poisk-1/hdd_card/kicad/hdd_card.kicad_pcb

## KiCad design kicad/hdd_card.kicad_pcb (2023-01-22)

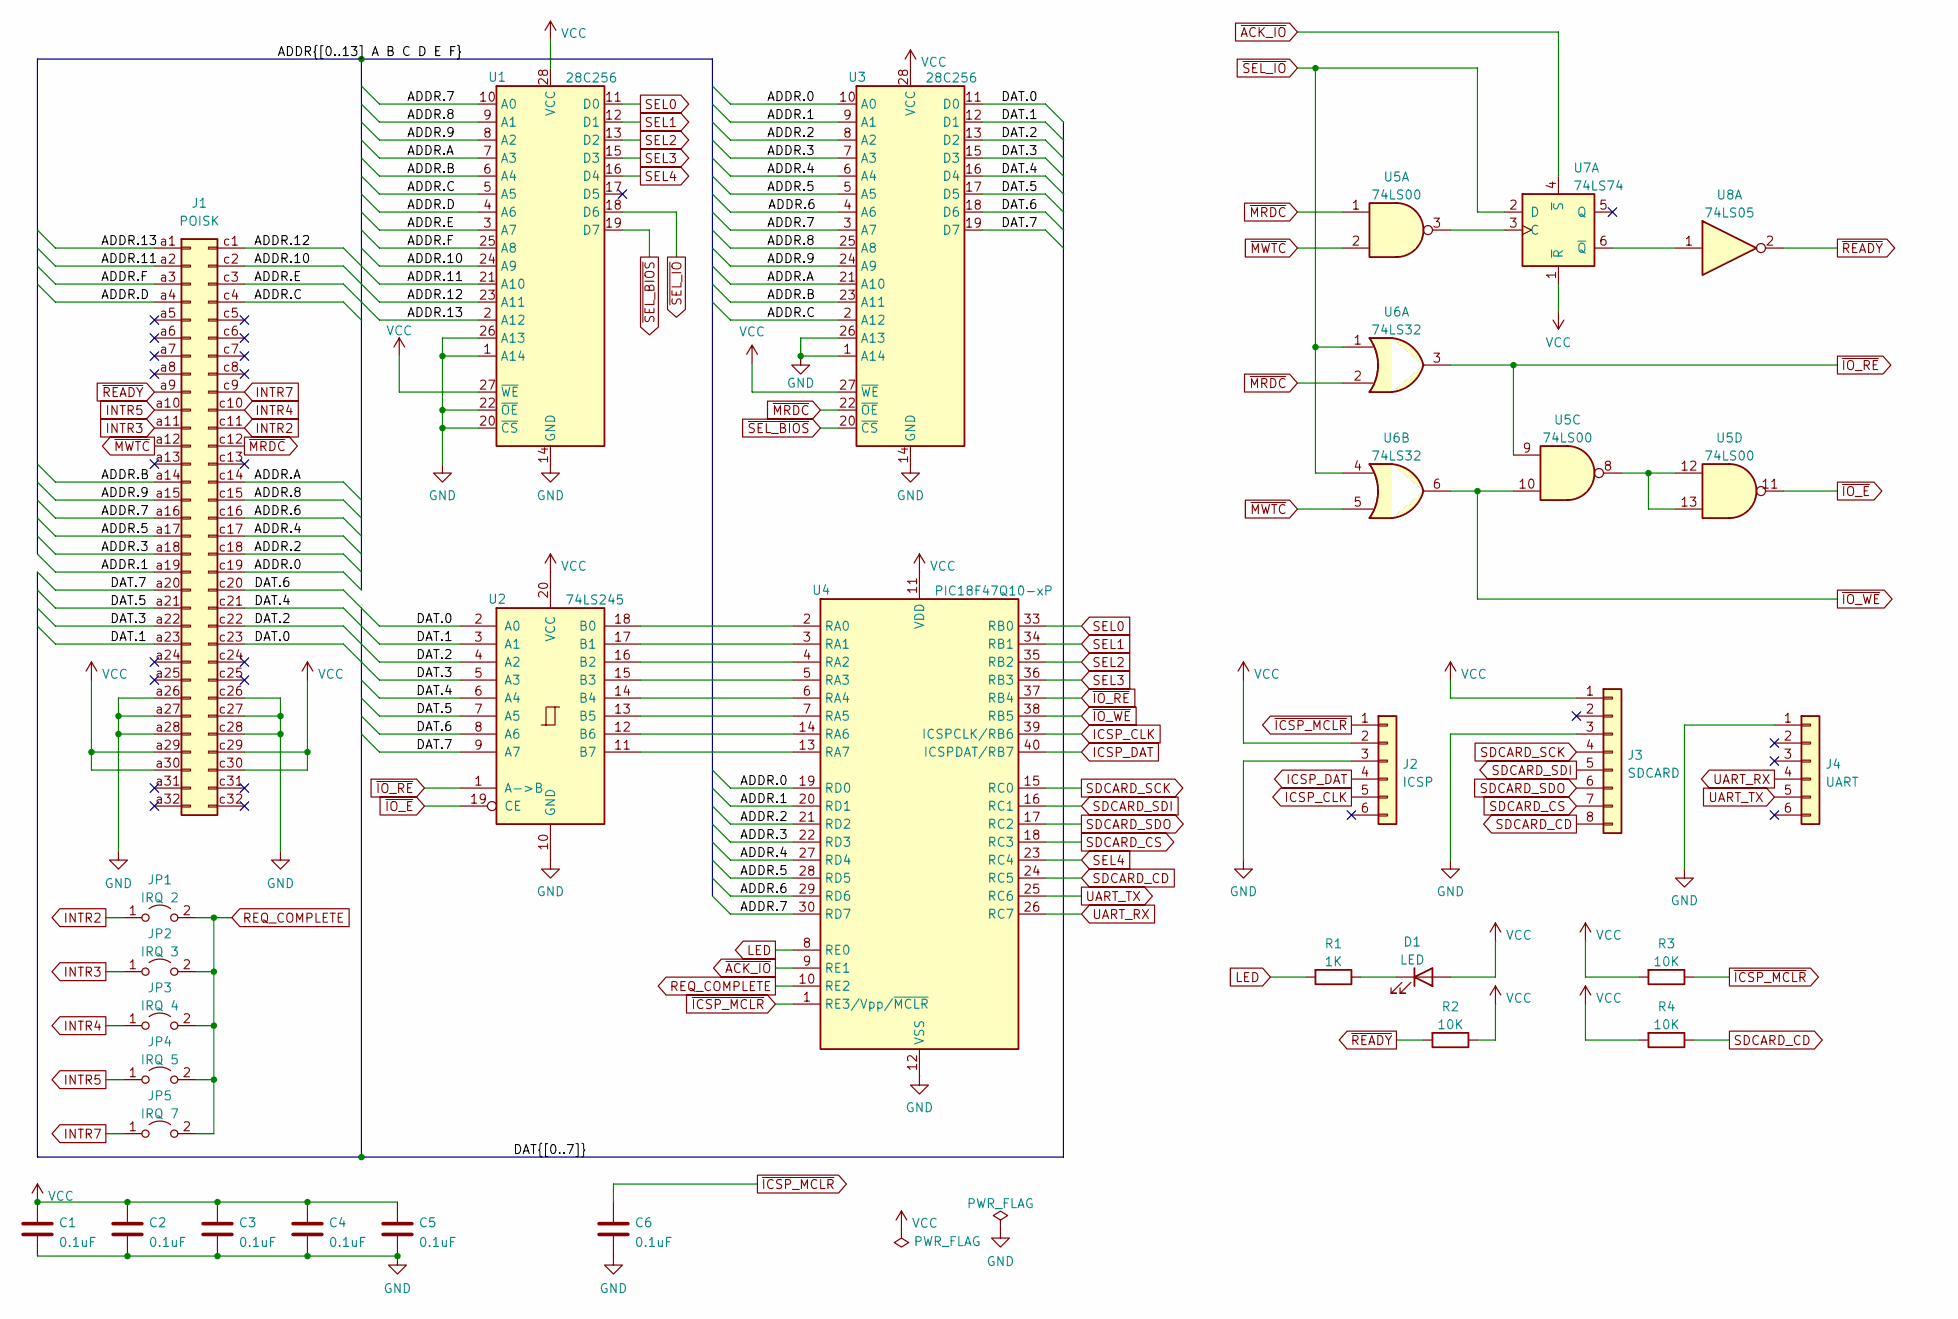
[picture p1: schematic hdd_card.kicad_sch]

Parts:
C1, C2, C3, C4, C5, C6: 0.1uF; C_Disc_D3.0mm_W1.6mm_P2.50mm
D1: LED; LED_D5.0mm
J1: POISK; DIN41612_R_2x32_Male_Horizontal_THT
J2: ICSP; PinHeader_1x06_P2.54mm_Vertical
J3: SDCARD; PinHeader_1x08_P2.54mm_Vertical
J4: UART; PinHeader_1x06_P2.54mm_Vertical
JP1: IRQ 2; PinHeader_1x02_P2.54mm_Vertical
JP2: IRQ 3; PinHeader_1x02_P2.54mm_Vertical
JP3: IRQ 4; PinHeader_1x02_P2.54mm_Vertical
JP4: IRQ 5; PinHeader_1x02_P2.54mm_Vertical
JP5: IRQ 7; PinHeader_1x02_P2.54mm_Vertical
R1: 1K; R_Axial_DIN0207_L6.3mm_D2.5mm_P7.62mm_Horizontal
R2, R3, R4: 10K; R_Axial_DIN0207_L6.3mm_D2.5mm_P7.62mm_Horizontal
U1, U3: 28C256; DIP-28_W15.24mm
U2: 74LS245; DIP-20_W7.62mm
U4: PIC18F47Q10-xP; DIP-40_W15.24mm
U5: 74LS00; DIP-14_W7.62mm
U6: 74LS32; DIP-14_W7.62mm
U7: 74LS74; DIP-14_W7.62mm
U8: 74LS05; DIP-14_W7.62mm

Connections:
/ADDR.0: J1.c19, U3.10 (A0), U4.19 (RD0)
/ADDR.1: J1.a19, U3.9 (A1), U4.20 (RD1)
/ADDR.2: J1.c18, U3.8 (A2), U4.21 (RD2)
/ADDR.3: J1.a18, U3.7 (A3), U4.22 (RD3)
/ADDR.4: J1.c17, U3.6 (A4), U4.27 (RD4)
/ADDR.5: J1.a17, U3.5 (A5), U4.28 (RD5)
/ADDR.6: J1.c16, U3.4 (A6), U4.29 (RD6)
/ADDR.7: J1.a16, U1.10 (A0), U3.3 (A7), U4.30 (RD7)
/ADDR.8: J1.c15, U1.9 (A1), U3.25 (A8)
/ADDR.9: J1.a15, U1.8 (A2), U3.24 (A9)
/ADDR.10: J1.c2, U1.24 (A9)
/ADDR.11: J1.a2, U1.21 (A10)
/ADDR.12: J1.c1, U1.23 (A11)
/ADDR.13: J1.a1, U1.2 (A12)
/ADDR.A: J1.c14, U1.7 (A3), U3.21 (A10)
/ADDR.B: J1.a14, U1.6 (A4), U3.23 (A11)
/ADDR.C: J1.c4, U1.5 (A5), U3.2 (A12)
/ADDR.D: J1.a4, U1.4 (A6)
/ADDR.E: J1.c3, U1.3 (A7)
/ADDR.F: J1.a3, U1.25 (A8)
/DAT.0: J1.c23, U2.2 (A0), U3.11 (D0)
/DAT.1: J1.a23, U2.3 (A1), U3.12 (D1)
/DAT.2: J1.c22, U2.4 (A2), U3.13 (D2)
/DAT.3: J1.a22, U2.5 (A3), U3.15 (D3)
/DAT.4: J1.c21, U2.6 (A4), U3.16 (D4)
/DAT.5: J1.a21, U2.7 (A5), U3.17 (D5)
/DAT.6: J1.c20, U2.8 (A6), U3.18 (D6)
/DAT.7: J1.a20, U2.9 (A7), U3.19 (D7)
GND: C1.2, C2.2, C3.2, C4.2, C5.2, C6.2, J1.a26, J1.a27, J1.a28, J1.c26, J1.c27, J1.c28, J2.3, J3.3, J4.1, U1.1 (A14), U1.14 (GND), U1.20 (~CS), U1.22 (~OE), U1.26 (A13), U2.10 (GND), U3.1 (A14), U3.14 (GND), U3.26 (A13), U4.12 (VSS), U4.31 (VSS)
ICSP_CLK: J2.5, U4.39 (ICSPCLK/RB6)
ICSP_DAT: J2.4, U4.40 (ICSPDAT/RB7)
INTR2: J1.c11, JP1.1 (A)
INTR3: J1.a11, JP2.1 (A)
INTR4: J1.c10, JP3.1 (A)
INTR5: J1.a10, JP4.1 (A)
INTR7: J1.c9, JP5.1 (A)
LED: R1.2, U4.8 (RE0)
unnamed: D1.1 (K), R1.1
unnamed: U2.11 (B7), U4.13 (RA7)
unnamed: U2.12 (B6), U4.14 (RA6)
unnamed: U2.13 (B5), U4.7 (RA5)
unnamed: U2.14 (B4), U4.6 (RA4)
unnamed: U2.15 (B3), U4.5 (RA3)
unnamed: U2.16 (B2), U4.4 (RA2)
unnamed: U2.17 (B1), U4.3 (RA1)
unnamed: U2.18 (B0), U4.2 (RA0)
unnamed: U5.3, U7.3 (C)
unnamed: U5.8, U5.12, U5.13
unnamed: U7.6 (~Q), U8.1
REQ_COMPLETE: JP1.2 (B), JP2.2 (B), JP3.2 (B), JP4.2 (B), JP5.2 (B), U4.10 (RE2)
SDCARD_CS: J3.7, U4.18 (RC3)
SDCARD_SCK: J3.4, U4.15 (RC0)
SDCARD_SDI: J3.5, U4.16 (RC1)
SDCARD_SDO: J3.6, U4.17 (RC2)
SEL0: U1.11 (D0), U4.33 (RB0)
SEL1: U1.12 (D1), U4.34 (RB1)
SEL2: U1.13 (D2), U4.35 (RB2)
SEL3: U1.15 (D3), U4.36 (RB3)
UART_RX: J4.4, U4.26 (RC7)
UART_TX: J4.5, U4.25 (RC6)
VCC: C1.1, C2.1, C3.1, C4.1, C5.1, D1.2 (A), J1.a29, J1.a30, J1.c29, J1.c30, J2.2, J3.1, R2.1, R3.2, R4.2, U1.27 (~WE), U1.28 (VCC), U2.20 (VCC), U3.27 (~WE), U3.28 (VCC), U4.11 (VDD), U4.32 (VDD), U7.1 (~R)
~ACK_IO: U4.9 (RE1), U7.4 (~S)
~ICSP_MCLR: C6.1, J2.1, R3.1, U4.1 (RE3/Vpp/~MCLR)
~IO_E: U2.19 (CE), U5.11
~IO_RE: U2.1 (A->B), U4.37 (RB4), U5.9, U6.3
~IO_WE: U4.38 (RB5), U5.10, U6.6
~MRDC: J1.c12, U3.22 (~OE), U5.1, U6.2
~MWTC: J1.a12, U5.2, U6.5
~READY: J1.a9, R2.2, U8.2
~SEL_BIOS: U1.19 (D7), U3.20 (~CS)
~SEL_IO: U1.18 (D6), U6.1, U6.4, U7.2 (D)

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
Board: 2 copper layers, 28 parts (0 on the bottom side), 72 nets, no tracks yet.
