poisk-1/hdd_card/firmware/hdd_card.X/main.c

/**
  Generated Main Source File

  Company:
    Microchip Technology Inc.

  File Name:
    main.c

  Summary:
    This is the main file generated using PIC10 / PIC12 / PIC16 / PIC18 MCUs

  Description:
    This header file provides implementations for driver APIs for all modules selected in the GUI.
    Generation Information :
        Product Revision  :  PIC10 / PIC12 / PIC16 / PIC18 MCUs - 1.81.8
        Device            :  PIC18F47Q83
        Driver Version    :  2.00
 */

/*
    (c) 2018 Microchip Technology Inc. and its subsidiaries. 
    
    Subject to your compliance with these terms, you may use Microchip software and any 
    derivatives exclusively with Microchip products. It is your responsibility to comply with third party 
    license terms applicable to your use of third party software (including open source software) that 
    may accompany Microchip software.
    
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
    IN NO EVENT WILL MICROCHIP BE LIABLE FOR ANY INDIRECT, SPECIAL, PUNITIVE, 
    INCIDENTAL OR CONSEQUENTIAL LOSS, DAMAGE, COST OR EXPENSE OF ANY KIND 
    WHATSOEVER RELATED TO THE SOFTWARE, HOWEVER CAUSED, EVEN IF MICROCHIP 
    HAS BEEN ADVISED OF THE POSSIBILITY OR THE DAMAGES ARE FORESEEABLE. TO 
    THE FULLEST EXTENT ALLOWED BY LAW, MICROCHIP'S TOTAL LIABILITY ON ALL 
    CLAIMS IN ANY WAY RELATED TO THIS SOFTWARE WILL NOT EXCEED THE AMOUNT 
    OF FEES, IF ANY, THAT YOU HAVE PAID DIRECTLY TO MICROCHIP FOR THIS 
    SOFTWARE.
 */

#include <string.h>

#include "mcc_generated_files/mcc.h"

static FATFS fs;

#define CTRL_BUFFER_SIZE 0x200
#define SECTOR_SIZE 0x200
#define BUFFER_SECTORS 15
#define DATA_BUFFER_SIZE (SECTOR_SIZE * BUFFER_SECTORS)
#define IO_BUFFER_SIZE (CTRL_BUFFER_SIZE + DATA_BUFFER_SIZE)

static uint8_t io_buffer[IO_BUFFER_SIZE];

static uint8_t *ctrl_buffer = &io_buffer[0];
static uint8_t *data_buffer = &io_buffer[CTRL_BUFFER_SIZE];

#define ACK_IO_Strobe() {ACK_IO_SetLow();ACK_IO_SetHigh();}

void __interrupt() INTERRUPT_InterruptManager(void) {
    if (PIE1bits.INT0IE == 1 && PIR1bits.INT0IF == 1) {
        EXT_INT0_InterruptFlagClear();        
        TRISA = 0x00;
        PORTA = io_buffer[(((PORTB & 0xf) | (PORTC & 0x10)) << 8) | PORTD];

        ACK_IO_Strobe();

        TRISA = 0xff;
    } else if (PIE6bits.INT1IE == 1 && PIR6bits.INT1IF == 1) {
        EXT_INT1_InterruptFlagClear();
        io_buffer[(((PORTB & 0xf) | (PORTC & 0x10)) << 8) | PORTD] = PORTA;

        ACK_IO_Strobe();
    }
}

enum Request {
    CTRL_REQUEST_DONE = 0,
    CTRL_REQUEST_CHECK = 0x1,
    CTRL_REQUEST_SCAN = 0x2,
    CTRL_REQUEST_RESET = 0x3,
    CTRL_REQUEST_READ = 0x4,
    CTRL_REQUEST_READ_NEXT = 0x5,
    CTRL_REQUEST_WRITE = 0x6,
    CTRL_REQUEST_WRITE_NEXT = 0x7,
    CTRL_REQUEST_VERIFY = 0x8,
    CTRL_REQUEST_READ_PARAMS_FUN8H = 0x9,
    CTRL_REQUEST_READ_PARAMS_FUN15H = 0xa,
    CTRL_REQUEST_DETECT_MEDIA_CHANGE = 0xb,
};

enum Status {
    CTRL_STATUS_READY = 0,
    CTRL_STATUS_BUSY = 0xff
};

enum DriveReqStatus {
    STATUS_NO_ERROR = 0,
    STATUS_BAD_SECTOR = 0x2,
    STATUS_WRITE_PROTECTED = 0x3,
    STATUS_DISK_CHANGED = 0x6,
    STATUS_CONTROLLER_FAILED = 0x20
};

void invert_buffer(uint8_t *buffer, size_t size) {
    for (size_t i = 0; i < size; i++) {
        buffer[i] = ~buffer[i];
    }
}

struct RWVReq {
    uint8_t low_cylinder_number;
    uint8_t sector_and_high_cylinder_numbers;
    uint8_t head_number;
    uint8_t drive_number;

    uint8_t sectors_count;

    uint8_t status;
    uint8_t sectors_last_r_next_w_count;
};

struct ScanReq {
    uint8_t number_of_floppy_drives;
    uint8_t number_of_hard_drives;
};

struct ReadParamsFun8hReq {
    uint8_t drive_number;

    uint8_t success;

    uint8_t drive_type;
    uint8_t max_low_cylinder_number;
    uint8_t max_sector_and_high_cylinder_numbers;
    uint8_t max_head_number;
    uint8_t number_of_drives;
};

struct ReadParamsFun15hReq {
    uint8_t drive_number;

    uint8_t success;

    uint8_t drive_type;
};

struct DetectMediaChangeReq {
    uint8_t drive_number;

    uint8_t status;
};

union Req {
    struct RWVReq rwv_req;
    struct ScanReq scan_req;
    struct ReadParamsFun8hReq read_params_fun8h_req;
    struct ReadParamsFun15hReq read_params_fun15h_req;
    struct DetectMediaChangeReq detect_media_change;
};

struct Ctrl {
    uint8_t status;
    uint8_t request;
    union Req req;
};

enum DriveTypeFun8h {
    FUN8H_DRIVE_TYPE_FLOPPY_360 = 1,
    FUN8H_DRIVE_TYPE_FLOPPY_1200 = 2,
    FUN8H_DRIVE_TYPE_FLOPPY_720 = 3,
    FUN8H_DRIVE_TYPE_FLOPPY_1440 = 4
};

enum DriveTypeFun15h {
    FUN15H_DRIVE_TYPE_FLOPPY_DISK = 2,
    FUN15H_DRIVE_TYPE_HARD_DISK = 3
};

struct Drive {
    FIL image_file;

    bool read_only;
    bool media_changed;

    uint8_t drive_type_fun8h;
    uint8_t drive_type_fun15h;

    size_t number_of_heads;
    size_t number_of_sectors;
    size_t number_of_cylinders;
};

#define MAX_NUMBER_FLOPPY_DRIVES 4
#define MAX_NUMBER_HARD_DRIVES 2

const char* floppy_image_file_names[MAX_NUMBER_FLOPPY_DRIVES] = {"FLOPPY0.IMG", "FLOPPY1.IMG", "FLOPPY2.IMG", "FLOPPY3.IMG"};
const char* floppy_info_file_names[MAX_NUMBER_FLOPPY_DRIVES] = {"FLOPPY0.TXT", "FLOPPY1.TXT", "FLOPPY2.TXT", "FLOPPY3.TXT"};
const char* floppy_ro_file_names[MAX_NUMBER_FLOPPY_DRIVES] = {"FLOPPY0.RO", "FLOPPY1.RO", "FLOPPY2.RO", "FLOPPY3.RO"};
const char* hard_image_file_names[MAX_NUMBER_HARD_DRIVES] = {"HARD0.IMG", "HARD1.IMG"};

struct Drive floppy_drives[MAX_NUMBER_FLOPPY_DRIVES];
struct Drive hard_drives[MAX_NUMBER_HARD_DRIVES];

#define FLOPPY_IMAGE_FILE_CLTBL_SIZE 16
#define HARD_IMAGE_FILE_CLTBL_SIZE 64

DWORD floppy_image_file_cltbl[MAX_NUMBER_FLOPPY_DRIVES][FLOPPY_IMAGE_FILE_CLTBL_SIZE];
DWORD hard_image_file_cltbl[MAX_NUMBER_HARD_DRIVES][HARD_IMAGE_FILE_CLTBL_SIZE];

#define FLOPPY_SECTOR_SIZE_BYTES 512

#define FLOPPY_1440_NUMBER_OF_HEADS 2
#define FLOPPY_1440_NUMBER_OF_SECTORS 18
#define FLOPPY_1440_NUMBER_OF_CYLINDERS 80

#define FLOPPY_720_SECTOR_SIZE_BYTES 512
#define FLOPPY_720_NUMBER_OF_HEADS 2
#define FLOPPY_720_NUMBER_OF_SECTORS 18
#define FLOPPY_720_NUMBER_OF_CYLINDERS 40

#define FLOPPY_1200_SECTOR_SIZE_BYTES 512
#define FLOPPY_1200_NUMBER_OF_HEADS 2
#define FLOPPY_1200_NUMBER_OF_SECTORS 15
#define FLOPPY_1200_NUMBER_OF_CYLINDERS 80

#define FLOPPY_360_SECTOR_SIZE_BYTES 512
#define FLOPPY_360_NUMBER_OF_HEADS 2
#define FLOPPY_360_NUMBER_OF_SECTORS 9
#define FLOPPY_360_NUMBER_OF_CYLINDERS 40

#define FLOPPY_180_SECTOR_SIZE_BYTES 512
#define FLOPPY_180_NUMBER_OF_HEADS 1
#define FLOPPY_180_NUMBER_OF_SECTORS 9
#define FLOPPY_180_NUMBER_OF_CYLINDERS 40

#define FLOPPY_320_SECTOR_SIZE_BYTES 512
#define FLOPPY_320_NUMBER_OF_HEADS 2
#define FLOPPY_320_NUMBER_OF_SECTORS 8
#define FLOPPY_320_NUMBER_OF_CYLINDERS 40

#define FLOPPY_160_SECTOR_SIZE_BYTES 512
#define FLOPPY_160_NUMBER_OF_HEADS 1
#define FLOPPY_160_NUMBER_OF_SECTORS 8
#define FLOPPY_160_NUMBER_OF_CYLINDERS 40

#define FLOPPY_INFO_TYPE_LENGTH 4
#define FLOPPY_INFO_TYPE_1440 "1440"
#define FLOPPY_INFO_TYPE_720 "0720"
#define FLOPPY_INFO_TYPE_1200 "1200"
#define FLOPPY_INFO_TYPE_360 "0360"
#define FLOPPY_INFO_TYPE_180 "0180"
#define FLOPPY_INFO_TYPE_320 "0320"
#define FLOPPY_INFO_TYPE_160 "0160"

#define HARD_SECTOR_SIZE_BYTES 512
#define HARD_NUMBER_OF_HEADS 16
#define HARD_NUMBER_OF_SECTORS 63
#define HARD_CYLINDER_SECTORS ((FSIZE_t)HARD_NUMBER_OF_HEADS * (FSIZE_t)HARD_NUMBER_OF_SECTORS)
#define HARD_CYLINDER_SIZE_BYTES ((FSIZE_t)HARD_SECTOR_SIZE_BYTES * HARD_CYLINDER_SECTORS)
#define HARD_MAX_NUMBER_OF_CYLINDERS 1024

bool is_hard_drive(uint8_t drive_number) {
    return drive_number & 0x80;
}

bool has_geometry(const struct Drive* drive) {
    return drive->number_of_cylinders != 0;
}

bool has_image(const struct Drive* drive) {
    return drive->image_file.obj.fs != NULL;
}

uint32_t disk_size_bytes(const struct Drive* drive) {
    return (uint32_t) drive->number_of_cylinders *
            (uint32_t) drive->number_of_heads *
            (uint32_t) drive->number_of_sectors *
            FLOPPY_SECTOR_SIZE_BYTES;
}

struct Drive* find_drive(uint8_t drive_number) {
    struct Drive* drive = NULL;
    size_t i = drive_number & 0xf;

    if (is_hard_drive(drive_number) && i < MAX_NUMBER_HARD_DRIVES) {
        drive = &hard_drives[i];
    } else if (i < MAX_NUMBER_FLOPPY_DRIVES) {
        drive = &floppy_drives[i];
    }

    return drive;
}

#define HIGH_CYLINDER_BITS 2
#define HIGH_CYLINDER_NUMBER_MASK ((uint8_t)0xc0)
#define SECTOR_NUMBER_MASK ((uint8_t)~HIGH_CYLINDER_NUMBER_MASK)

bool chs_to_lba(const struct Drive* drive, const struct RWVReq* disk_req, uint32_t *lba) {
    uint32_t cylinder_number =
            (uint32_t) disk_req->low_cylinder_number |
            (((uint32_t) disk_req->sector_and_high_cylinder_numbers & HIGH_CYLINDER_NUMBER_MASK) << HIGH_CYLINDER_BITS);

    uint32_t sector_number =
            (uint32_t) disk_req->sector_and_high_cylinder_numbers & SECTOR_NUMBER_MASK;

    if (cylinder_number < drive->number_of_cylinders &&
            disk_req->head_number < drive->number_of_heads &&
            sector_number <= drive->number_of_sectors) {
        *lba = ((uint32_t) cylinder_number * drive->number_of_heads +
                (uint32_t) disk_req->head_number) * drive->number_of_sectors +
                ((uint32_t) sector_number - 1);

        return true;
    }

    return false;
}

void set_params_fun8h(const struct Drive* drive, struct ReadParamsFun8hReq* req) {
    req->success = 1;
    req->drive_type = drive->drive_type_fun8h;
    req->max_low_cylinder_number = (uint8_t) ((drive->number_of_cylinders - 1) & 0xff);
    req->max_head_number = (uint8_t) drive->number_of_heads - 1;
    req->max_sector_and_high_cylinder_numbers =
            (uint8_t) (drive->number_of_sectors & SECTOR_NUMBER_MASK) |
            (uint8_t) (((drive->number_of_cylinders - 1) >> HIGH_CYLINDER_BITS) & HIGH_CYLINDER_NUMBER_MASK);
}

#if FF_MAX_SS == FF_MIN_SS
#define SS(fs)	((UINT)FF_MAX_SS)	/* Fixed sector size */
#else
#define SS(fs)	((fs)->ssize)	/* Variable sector size */
#endif

static DWORD clmt_clust(/* <2:Error, >=2:Cluster number */
        FIL* fp, /* Pointer to the file object */
        FSIZE_t ofs /* File offset to be converted to cluster# */
        ) {
    DWORD cl, ncl, *tbl;
    FATFS *fs = fp->obj.fs;


    tbl = fp->cltbl + 1; /* Top of CLMT */
    cl = (DWORD) (ofs / SS(fs) / fs->csize); /* Cluster order from top of the file */
    for (;;) {
        ncl = *tbl++; /* Number of cluters in the fragment */
        if (ncl == 0) return 0; /* End of table? (error) */
        if (cl < ncl) break; /* In this fragment? */
        cl -= ncl;
        tbl++; /* Next fragment */
    }
    return cl + *tbl; /* Return the cluster number */
}

static DWORD clst2sect(/* !=0:Sector number, 0:Failed (invalid cluster#) */
        FATFS* fs, /* Filesystem object */
        DWORD clst /* Cluster# to be converted */
        ) {
    clst -= 2; /* Cluster number is origin from 2 */
    if (clst >= fs->n_fatent - 2) return 0; /* Is it invalid cluster number? */
    return fs->database + fs->csize * clst; /* Start sector number of the cluster */
}

static FRESULT offset2sector(FIL *file, FSIZE_t offset, DWORD *sector) {
    DWORD cluster;
    FATFS *fs = file->obj.fs;

    cluster = clmt_clust(file, offset);
    if (cluster < 2) return FR_INT_ERR;

    *sector = clst2sect(fs, cluster);
    if (*sector == 0) return FR_INT_ERR;

    *sector += (DWORD) (offset / SS(fs)) & (fs->csize - 1);

    return FR_OK;
}

static FRESULT setup_clmt(FIL *fp, DWORD *cltbl, DWORD cltbl_size) {
    cltbl[0] = cltbl_size;
    fp->cltbl = cltbl;

    return FR_OK;
}

#define SD_COMMAND_CODE_BIT_MASK (0b00111111)
#define SD_COMMAND_TRANSMIT_BIT_MASK (1<<6)

#define SD_WRITE_RESPONSE_TOKEN_MASK   0x1F  //Bit mask to AND with the write token response uint8_t from the media, to clear the don't care bits.

enum SD_TOKEN {
    SD_TOKEN_START = 0xFE,
    SD_TOKEN_START_MULTI_BLOCK = 0xFC,
    SD_TOKEN_STOP_TRANSMISSION = 0xFD,
    SD_TOKEN_DATA_ACCEPTED = 0x05,
    SD_TOKEN_FLOATING_BUS = 0xFF
};

enum SD_COMMAND {
    // Description: This macro defines the command code to reset the SD card
    SD_COMMAND_GO_IDLE_STATE = 0,
    // Description: This macro defines the command code to initialize the SD card
    SD_COMMAND_SEND_OP_COND = 1,
    // Description: This macro defined the command code to check for sector addressing
    SD_COMMAND_SEND_IF_COND = 8,
    // Description: This macro defines the command code to get the Card Specific Data
    SD_COMMAND_SEND_CSD = 9,
    // Description: This macro defines the command code to get the Card Information
    SD_COMMAND_SEND_CID = 10,
    // Description: This macro defines the command code to stop transmission during a multi-block read
    SD_COMMAND_STOP_TRANSMISSION = 12,
    // Description: This macro defines the command code to get the card status information
    SD_COMMAND_SEND_STATUS = 13,
    // Description: This macro defines the command code to set the block length of the card
    SD_COMMAND_SET_BLOCK_LENGTH = 16,
    // Description: This macro defines the command code to read one block from the card
    SD_COMMAND_READ_SINGLE_BLOCK = 17,
    // Description: This macro defines the command code to read multiple blocks from the card
    SD_COMMAND_READ_MULTI_BLOCK = 18,
    // Description: This macro defines the command code to tell the media how many blocks to pre-erase (for faster multi-block writes to follow)
    //Note: This is an "application specific" command.  This tells the media how many blocks to pre-erase for the subsequent WRITE_MULTI_BLOCK
    SD_COMMAND_SET_WRITE_BLOCK_ERASE_COUNT = 23,
    // Description: This macro defines the command code to write one block to the card
    SD_COMMAND_WRITE_SINGLE_BLOCK = 24,
    // Description: This macro defines the command code to write multiple blocks to the card
    SD_COMMAND_WRITE_MULTI_BLOCK = 25,
    // Description: This macro defines the command code to set the address of the start of an erase operation
    SD_COMMAND_TAG_SECTOR_START = 32,
    // Description: This macro defines the command code to set the address of the end of an erase operation
    SD_COMMAND_TAG_SECTOR_END = 33,
    // Description: This macro defines the command code to erase all previously selected blocks
    SD_COMMAND_ERASE = 38,
    //Description: This macro defines the command code to initialize an SD card and provide the CSD register value.
    //Note: this is an "application specific" command (specific to SD cards) and must be preceded by cmdAPP_CMD.
    SD_COMMAND_SD_SEND_OP_COND = 41,
    // Description: This macro defines the command code to begin application specific command inputs
    SD_COMMAND_APP_CMD = 55,
    // Description: This macro defines the command code to get the OCR register information from the card
    SD_COMMAND_READ_OCR = 58,
    // Description: This macro defines the command code to disable CRC checking
    SD_COMMAND_CRC_ON_OFF = 59
};

#define SD_NCR_TIMEOUT     (uint16_t)20          //byte times before command response is expected (must be at least 8)
#define SD_NAC_TIMEOUT     (uint32_t)0x40000     //SPI byte times we should wait when performing read operations (should be at least 100ms for SD cards)
#define SD_WRITE_TIMEOUT   (uint32_t)0xA0000     //SPI byte times to wait before timing out when the media is performing a write operation (should be at least 250ms for SD cards).

#define SD_SPI_ChipSelect() SDCard_CS_SetLow()
#define SD_SPI_ChipDeselect() SDCard_CS_SetHigh()

uint8_t wait_for_command_response() {
    uint16_t timeout = SD_NCR_TIMEOUT;
    uint8_t response;
    do {
        response = SPI1_ExchangeByte(0xFF);
        timeout--;
    } while ((response == SD_TOKEN_FLOATING_BUS) && (timeout != 0));

    return response;
}

void wait_busy() {
    uint32_t long_timeout = SD_WRITE_TIMEOUT;
    uint8_t response;
    do {
        response = SPI1_ExchangeByte(0xFF);
        long_timeout--;
    } while ((response == 0x00) && (long_timeout != 0));
}

uint8_t send_command(uint8_t command, uint32_t param) {
    (void) SPI1_ExchangeByte((command & SD_COMMAND_CODE_BIT_MASK) | SD_COMMAND_TRANSMIT_BIT_MASK);

    uint8_t *param_bytes = (uint8_t *) & param;

    (void) SPI1_ExchangeByte(param_bytes[3]);
    (void) SPI1_ExchangeByte(param_bytes[2]);
    (void) SPI1_ExchangeByte(param_bytes[1]);
    (void) SPI1_ExchangeByte(param_bytes[0]);


    if (command == SD_COMMAND_STOP_TRANSMISSION) {
        (void) SPI1_ExchangeByte(0xC3); // CRC
        (void) SPI1_ExchangeByte(0xFF); //Perform dummy read to fetch the residual non R1 byte
    } else {
        (void) SPI1_ExchangeByte(0xFF); // CRC
    }

    uint8_t response = wait_for_command_response();

    if (command == SD_COMMAND_STOP_TRANSMISSION) {
        wait_busy();
    }

    (void) SPI1_ExchangeByte(0xFF);

    return response;
}

void start_transaction() {
    SPI1_Open(SDFAST_CONFIG);
    SD_SPI_ChipSelect();
}

void end_transaction() {
    SD_SPI_ChipDeselect(); // De-select media
    (void) SPI1_ExchangeByte(0xFF);

    SPI1_Close();
}

bool start_read_sectors(uint32_t address) {
    start_transaction();

    uint8_t response = send_command(SD_COMMAND_READ_MULTI_BLOCK, address);
    return (response == 0);
}

bool start_write_sectors(uint32_t address) {
    start_transaction();

    uint8_t response = send_command(SD_COMMAND_WRITE_MULTI_BLOCK, address);
    return (response == 0);
}

uint8_t wait_for_token() {
    uint32_t long_timeout = SD_NAC_TIMEOUT;
    uint8_t response;
    do {
        response = SPI1_ExchangeByte(0xFF);
        long_timeout--;
    } while ((response == SD_TOKEN_FLOATING_BUS) && (long_timeout != 0));
    return response;
}

bool read_next_sector(uint8_t *buffer) {
    uint8_t *ptr = buffer;
    if (wait_for_token() == SD_TOKEN_START) {
        for (size_t j = 0; j < 0x200; j++, ptr++) {
            *ptr = SPI1_ExchangeByte(0xFF);
        }

        // CRC
        SPI1_ExchangeByte(0xFF);
        SPI1_ExchangeByte(0xFF);

        return true;
    }

    return false;
}

bool write_next_sector(uint8_t *buffer) {
    SPI1_ExchangeByte(SD_TOKEN_START_MULTI_BLOCK);

    uint8_t *ptr = buffer;
    for (size_t j = 0; j < 0x200; j++, ptr++) {
        SPI1_ExchangeByte(*ptr);
    }

    // CRC
    SPI1_ExchangeByte(0xFF);
    SPI1_ExchangeByte(0xFF);

    uint8_t response = SPI1_ExchangeByte(0xFF);

    SPI1_ExchangeByte(0xFF);

    wait_busy();

    return (response & SD_WRITE_RESPONSE_TOKEN_MASK) == SD_TOKEN_DATA_ACCEPTED;
}

void stop_read_sectors() {
    (void) send_command(SD_COMMAND_STOP_TRANSMISSION, 0);

    end_transaction();
}

void stop_write_sectors() {
    SPI1_ExchangeByte(SD_TOKEN_STOP_TRANSMISSION);

    SPI1_ExchangeByte(0xFF);

    wait_busy();

    end_transaction();
}

#define NEXT_TIMEOUT 20000

struct MultisectorTransfer {
    void (*stop)(void);
    bool(*start)(uint32_t);
    bool(*tx)(uint8_t *);

    uint32_t last_sector;
    uint32_t timeout;
};

void init_transfer(struct MultisectorTransfer *mst,
        void (*stop)(void),
        bool(*start)(uint32_t),
        bool(*tx)(uint8_t *)
        ) {
    mst->stop = stop;
    mst->start = start;
    mst->tx = tx;

    mst->last_sector = 0;
    mst->timeout = 0;
}

bool stop_transfer_if_expired(struct MultisectorTransfer *mst) {
    if (mst->timeout) {
        if (!--mst->timeout) {
            mst->stop();
            return true;
        }
    }
    return false;
}

void stop_transfer(struct MultisectorTransfer *mst) {
    if (mst->timeout) {
        mst->stop();
        mst->timeout = 0;
    }
}

void abort_transfer(struct MultisectorTransfer *mst) {
    mst->timeout = 0;
}

bool transfer_next_sector(struct MultisectorTransfer *mst, uint32_t sector, uint8_t *sector_buffer) {
    if (mst->timeout) {
        if (mst->last_sector + 1 == sector) {
            if (mst->tx(sector_buffer)) {
                mst->last_sector = sector;
                mst->timeout = NEXT_TIMEOUT;
                return true;
            } else {
                mst->stop();
                mst->timeout = 0;
            }
        } else {
            mst->stop();

            if (mst->start(sector) && mst->tx(sector_buffer)) {
                mst->last_sector = sector;
                mst->timeout = NEXT_TIMEOUT;
                return true;
            } else {
                mst->stop();
                mst->timeout = 0;
            }
        }
    } else {
        if (mst->start(sector) && mst->tx(sector_buffer)) {
            mst->last_sector = sector;
            mst->timeout = NEXT_TIMEOUT;
            return true;
        } else {
            mst->stop();
        }
    }
    return false;
}

void wait_or_handle_ctrl_request(struct Ctrl *ctrl, void(*wait)(void), void(*handle)(struct Ctrl *)) {
    if (ctrl->request == CTRL_REQUEST_DONE) {
        wait();
    } else {
        ctrl->status = CTRL_STATUS_BUSY;
        LED_SetLow();

        handle(ctrl);

        ctrl->status = CTRL_STATUS_READY;
        REQ_COMPLETE_SetHigh();
        while (ctrl->request != CTRL_REQUEST_DONE);
        REQ_COMPLETE_SetLow();
        LED_SetHigh();
    }
}

static struct Drive* current_read_drive = NULL;
static uint32_t current_read_lba = 0;
static uint32_t current_read_sector = 0;

static struct MultisectorTransfer read_mst;

static struct Drive* current_write_drive = NULL;
static uint32_t current_write_lba = 0;
static uint32_t current_write_sector = 0;

static struct MultisectorTransfer write_mst;

static void wait_media_present() {
    stop_transfer_if_expired(&read_mst);
    stop_transfer_if_expired(&write_mst);
}

static void handle_media_present(struct Ctrl *ctrl) {
    struct Drive* drive = NULL;
    uint32_t lba = 0;
    uint32_t sector = 0;

    if (ctrl->request != CTRL_REQUEST_READ &&
            ctrl->request != CTRL_REQUEST_READ_NEXT) {
        stop_transfer(&read_mst);
    }

    if (ctrl->request != CTRL_REQUEST_WRITE &&
            ctrl->request != CTRL_REQUEST_WRITE_NEXT) {
        stop_transfer(&write_mst);
    }

    switch (ctrl->request) {
        case CTRL_REQUEST_CHECK:
#ifdef DEBUG
            printf("CHECK\r\n");
#endif
            invert_buffer(data_buffer, DATA_BUFFER_SIZE);
            break;

        case CTRL_REQUEST_SCAN:
#ifdef DEBUG
            printf("SCAN\r\n");
#endif
            ctrl->req.scan_req.number_of_floppy_drives = 0;

            for (size_t i = 0; i < MAX_NUMBER_FLOPPY_DRIVES; i++) {
                if (has_geometry(&floppy_drives[i])) {
                    ctrl->req.scan_req.number_of_floppy_drives++;
                }
            }

            ctrl->req.scan_req.number_of_hard_drives = 0;

            for (size_t i = 0; i < MAX_NUMBER_HARD_DRIVES; i++) {
                if (has_geometry(&hard_drives[i])) {
                    ctrl->req.scan_req.number_of_hard_drives++;
                }
            }

            break;

        case CTRL_REQUEST_RESET:
#ifdef DEBUG
            printf("RESET[d=%d]\r\n", ctrl->req.rwv_req.drive_number);
#endif
            ctrl->req.rwv_req.status = 0;

            break;

        case CTRL_REQUEST_READ:
            current_read_drive = find_drive(ctrl->req.rwv_req.drive_number);

#ifdef DEBUG
            printf(
                    "READ[d=%d,lc=%d,h=%d,shc=%d,sct=%d]",
                    ctrl->req.rwv_req.drive_number,
                    ctrl->req.rwv_req.low_cylinder_number,
                    ctrl->req.rwv_req.head_number,
                    ctrl->req.rwv_req.sector_and_high_cylinder_numbers,
                    ctrl->req.rwv_req.sectors_count
                    );
#endif

            if (!(current_read_drive && has_image(current_read_drive) && chs_to_lba(current_read_drive, &ctrl->req.rwv_req, &current_read_lba))) {
#ifdef DEBUG
                printf("[no lba]\r\n");
#endif
                ctrl->req.rwv_req.status = STATUS_BAD_SECTOR;
                break;
            }


        case CTRL_REQUEST_READ_NEXT:
#ifdef DEBUG
            if (ctrl->request == CTRL_REQUEST_READ_NEXT) {
                printf("READ_NEXT[lct=%d,sct=%d]",
                        ctrl->req.rwv_req.sectors_last_r_next_w_count,
                        ctrl->req.rwv_req.sectors_count);
            }
#endif
            ctrl->req.rwv_req.sectors_last_r_next_w_count = 0;
            ctrl->req.rwv_req.status = 0;

            if (ctrl->req.rwv_req.sectors_count != 0) {
                uint8_t sectors_to_read = ctrl->req.rwv_req.sectors_count;
                if (sectors_to_read > BUFFER_SECTORS) sectors_to_read = BUFFER_SECTORS;

                for (uint8_t i = 0; i < sectors_to_read; i++) {
                    if (offset2sector(&current_read_drive->image_file, (FSIZE_t) SECTOR_SIZE * current_read_lba, &current_read_sector) == FR_OK) {
                        if (transfer_next_sector(&read_mst, current_read_sector, &data_buffer[i * SECTOR_SIZE])) {
                            ctrl->req.rwv_req.sectors_last_r_next_w_count++;
                            ctrl->req.rwv_req.sectors_count--;

#ifdef DEBUG
                            printf("[lba=%lu]", current_read_lba);
#endif

                            current_read_lba++;
                        } else {
#ifdef DEBUG
                            printf("[read error]");
#endif
                            ctrl->req.rwv_req.status = STATUS_BAD_SECTOR;
                            break;
                        }
                    } else {
#ifdef DEBUG
                        printf("[no sector]");
#endif
                        ctrl->req.rwv_req.status = STATUS_BAD_SECTOR;
                        break;
                    }
                }
#ifdef DEBUG
                printf("[lct=%d,sct=%d]\r\n",
                        ctrl->req.rwv_req.sectors_last_r_next_w_count,
                        ctrl->req.rwv_req.sectors_count);
#endif

            } else {
#ifdef DEBUG
                printf("[nothing to read]\r\n");
#endif
            }

            break;

        case CTRL_REQUEST_WRITE:
            current_write_drive = find_drive(ctrl->req.rwv_req.drive_number);
#ifdef DEBUG
            printf(
                    "WRITE[d=%d,lc=%d,h=%d,shc=%d,sct=%d]",
                    ctrl->req.rwv_req.drive_number,
                    ctrl->req.rwv_req.low_cylinder_number,
                    ctrl->req.rwv_req.head_number,
                    ctrl->req.rwv_req.sector_and_high_cylinder_numbers,
                    ctrl->req.rwv_req.sectors_count
                    );
#endif

            ctrl->req.rwv_req.sectors_last_r_next_w_count = 0;
            ctrl->req.rwv_req.status = 0;

            if (current_write_drive && has_image(current_write_drive) && chs_to_lba(current_write_drive, &ctrl->req.rwv_req, &current_write_lba)) {
                if (current_write_drive->read_only) {
#ifdef DEBUG
                    printf("[write protected]\r\n");
#endif
                    ctrl->req.rwv_req.status = STATUS_WRITE_PROTECTED;
                } else {
                    if (ctrl->req.rwv_req.sectors_count != 0) {
                        uint8_t sectors_to_write = ctrl->req.rwv_req.sectors_count;
                        if (sectors_to_write > BUFFER_SECTORS) sectors_to_write = BUFFER_SECTORS;

                        ctrl->req.rwv_req.sectors_last_r_next_w_count += sectors_to_write;
                        ctrl->req.rwv_req.sectors_count -= sectors_to_write;

#ifdef DEBUG
                        printf("[nct=%d,sct=%d]\r\n",
                                ctrl->req.rwv_req.sectors_last_r_next_w_count,
                                ctrl->req.rwv_req.sectors_count);
#endif

                    } else {
#ifdef DEBUG
                        printf("[nothing to write]\r\n");
#endif                                        
                    }
                }
            } else {
#ifdef DEBUG
                printf("[no lba]\r\n");
#endif
                ctrl->req.rwv_req.status = STATUS_BAD_SECTOR;
            }

            break;

        case CTRL_REQUEST_WRITE_NEXT:
#ifdef DEBUG
            printf("WRITE_NEXT[nct=%d,sct=%d]",
                    ctrl->req.rwv_req.sectors_last_r_next_w_count,
                    ctrl->req.rwv_req.sectors_count);
#endif

            ctrl->req.rwv_req.status = 0;

            if (ctrl->req.rwv_req.sectors_last_r_next_w_count != 0) {
                for (uint8_t i = 0; i < ctrl->req.rwv_req.sectors_last_r_next_w_count; i++) {
                    if (offset2sector(&current_write_drive->image_file, (FSIZE_t) SECTOR_SIZE * current_write_lba, &current_write_sector) == FR_OK) {
                        if (transfer_next_sector(&write_mst, current_write_sector, &data_buffer[i * SECTOR_SIZE])) {
#ifdef DEBUG
                            printf("[lba=%lu]", current_write_lba);
#endif
                            current_write_lba++;
                        } else {
#ifdef DEBUG
                            printf("[write error]");
#endif                                        
                            ctrl->req.rwv_req.status = STATUS_BAD_SECTOR;
                            break;

                        }
                    } else {
#ifdef DEBUG
                        printf("[no sector]");
#endif                                        
                        ctrl->req.rwv_req.status = STATUS_BAD_SECTOR;
                        break;
                    }
                }

                ctrl->req.rwv_req.sectors_last_r_next_w_count = 0;

                if (ctrl->req.rwv_req.status == 0 && ctrl->req.rwv_req.sectors_count != 0) {
                    uint8_t sectors_to_write = ctrl->req.rwv_req.sectors_count;
                    if (sectors_to_write > BUFFER_SECTORS) sectors_to_write = BUFFER_SECTORS;

                    ctrl->req.rwv_req.sectors_last_r_next_w_count += sectors_to_write;
                    ctrl->req.rwv_req.sectors_count -= sectors_to_write;

                }
#ifdef DEBUG
                printf("[nct=%d,sct=%d]\r\n",
                        ctrl->req.rwv_req.sectors_last_r_next_w_count,
                        ctrl->req.rwv_req.sectors_count);
#endif                                    
            } else {
#ifdef DEBUG
                printf("[nothing to write]\r\n");
#endif                                        
            }

            break;

        case CTRL_REQUEST_VERIFY:
            drive = find_drive(ctrl->req.rwv_req.drive_number);
#ifdef DEBUG
            printf(
                    "VERIFY[d=%d,lc=%d,h=%d,shc=%d,sct=%d]",
                    ctrl->req.rwv_req.drive_number,
                    ctrl->req.rwv_req.low_cylinder_number,
                    ctrl->req.rwv_req.head_number,
                    ctrl->req.rwv_req.sector_and_high_cylinder_numbers,
                    ctrl->req.rwv_req.sectors_count
                    );
#endif

            if (!(drive && has_image(drive) && chs_to_lba(drive, &ctrl->req.rwv_req, &lba))) {
#ifdef DEBUG
                printf("[no lba]\r\n");
#endif
                ctrl->req.rwv_req.status = STATUS_BAD_SECTOR;
            } else {
                ctrl->req.rwv_req.status = 0;

                while (ctrl->req.rwv_req.sectors_count != 0) {
                    if (offset2sector(&drive->image_file, (FSIZE_t) SECTOR_SIZE * lba, &sector) == FR_OK) {
#ifdef DEBUG
                        printf("[lba=%lu]", lba);
#endif
                        ctrl->req.rwv_req.sectors_count--;
                        lba++;

                    } else {
#ifdef DEBUG
                        printf("[no sector]");
#endif
                        ctrl->req.rwv_req.status = STATUS_BAD_SECTOR;
                        break;
                    }
                }
#ifdef DEBUG
                printf("\r\n");
#endif                                
            }

            break;

        case CTRL_REQUEST_READ_PARAMS_FUN8H:
            ctrl->req.read_params_fun8h_req.number_of_drives = 0;

            if (is_hard_drive(ctrl->req.read_params_fun8h_req.drive_number)) {
                for (size_t i = 0; i < MAX_NUMBER_HARD_DRIVES; i++) {
                    if (has_geometry(&hard_drives[i])) {
                        ctrl->req.read_params_fun8h_req.number_of_drives++;
                    }
                }
            } else {
                for (size_t i = 0; i < MAX_NUMBER_FLOPPY_DRIVES; i++) {
                    if (has_geometry(&floppy_drives[i])) {
                        ctrl->req.read_params_fun8h_req.number_of_drives++;
                    }
                }
            }

            drive = find_drive(ctrl->req.read_params_fun8h_req.drive_number);

#ifdef DEBUG
            printf(
                    "READ_PARAMS_FUN8H[d=%d]",
                    ctrl->req.read_params_fun8h_req.drive_number
                    );
#endif                                

            if (drive && has_geometry(drive)) {
                set_params_fun8h(drive, &ctrl->req.read_params_fun8h_req);
#ifdef DEBUG
                printf(
                        "[mlc=%d,mh=%d,mshc=%d]\r\n",
                        ctrl->req.read_params_fun8h_req.max_low_cylinder_number,
                        ctrl->req.read_params_fun8h_req.max_head_number,
                        ctrl->req.read_params_fun8h_req.max_sector_and_high_cylinder_numbers
                        );
#endif                                
            } else {
#ifdef DEBUG
                printf("[no geometry]\r\n");
#endif                                
                ctrl->req.read_params_fun8h_req.success = 0;
                ctrl->req.read_params_fun8h_req.drive_type = 0;
                ctrl->req.read_params_fun8h_req.max_low_cylinder_number = 0;
                ctrl->req.read_params_fun8h_req.max_head_number = 0;
                ctrl->req.read_params_fun8h_req.max_sector_and_high_cylinder_numbers = 0;
            }

            break;

        case CTRL_REQUEST_READ_PARAMS_FUN15H:
            drive = find_drive(ctrl->req.read_params_fun15h_req.drive_number);
#ifdef DEBUG
            printf(
                    "READ_PARAMS_FUN15H[d=%d]",
                    ctrl->req.read_params_fun15h_req.drive_number
                    );
#endif

            if (drive && has_geometry(drive)) {
#ifdef DEBUG
                printf("[t=%d]\r\n", drive->drive_type_fun15h);
#endif

                ctrl->req.read_params_fun15h_req.success = 1;
                ctrl->req.read_params_fun15h_req.drive_type = drive->drive_type_fun15h;
            } else {
#ifdef DEBUG
                printf("[no geometry]\r\n");
#endif
                ctrl->req.read_params_fun15h_req.success = 0;
                ctrl->req.read_params_fun15h_req.drive_type = 0;
            }

            break;

        case CTRL_REQUEST_DETECT_MEDIA_CHANGE:
            drive = find_drive(ctrl->req.detect_media_change.drive_number);
#ifdef DEBUG
            printf(
                    "DETECT_MEDIA_CHANGE[d=%d",
                    ctrl->req.detect_media_change.drive_number
                    );
#endif

            if (drive && has_image(drive)) {
                if (drive->media_changed) {
                    drive->media_changed = false;
#ifdef DEBUG
                    printf("[media changed]\r\n");
#endif
                    ctrl->req.detect_media_change.status = STATUS_DISK_CHANGED;
                } else {
#ifdef DEBUG
                    printf("[media not changed]\r\n");
#endif
                    ctrl->req.detect_media_change.status = 0;
                }
            } else {
                ctrl->req.rwv_req.status = STATUS_BAD_SECTOR;
            }
            break;

        default:
#ifdef DEBUG
            printf("UNKNOWN REQUEST %d\r\n", ctrl->request);
#endif
            break;
    }
}

static void wait_media_not_present() {
}

static void handle_media_not_present(struct Ctrl *ctrl) {
    switch (ctrl->request) {
        case CTRL_REQUEST_CHECK:
            invert_buffer(data_buffer, DATA_BUFFER_SIZE);
            break;

        case CTRL_REQUEST_SCAN:
            ctrl->req.scan_req.number_of_floppy_drives = 0;
            ctrl->req.scan_req.number_of_hard_drives = 0;
            break;

        case CTRL_REQUEST_RESET:
        case CTRL_REQUEST_READ:
        case CTRL_REQUEST_WRITE:
        case CTRL_REQUEST_VERIFY:
            ctrl->req.rwv_req.status = STATUS_CONTROLLER_FAILED;
            break;

        case CTRL_REQUEST_READ_PARAMS_FUN8H:
            ctrl->req.read_params_fun8h_req.number_of_drives = 0;
            ctrl->req.read_params_fun8h_req.success = 0;
            break;

        case CTRL_REQUEST_READ_PARAMS_FUN15H:
            ctrl->req.read_params_fun15h_req.success = 0;
            break;

        default:
            break;

    }
}

static bool init_drives(void) {
    if (f_mount(&fs, "0:", 1) != FR_OK) return false;

    memset(&floppy_drives, 0, sizeof (struct Drive) * MAX_NUMBER_FLOPPY_DRIVES);
    memset(&hard_drives, 0, sizeof (struct Drive) * MAX_NUMBER_HARD_DRIVES);

    static FILINFO file_info;

    for (size_t i = 0; i < MAX_NUMBER_FLOPPY_DRIVES; i++) {
        static FIL info_file;
        static char info[FLOPPY_INFO_TYPE_LENGTH + 1];
        memset(info, 0, FLOPPY_INFO_TYPE_LENGTH + 1);
        UINT read_bytes = 0;

        if (
                f_open(&info_file, floppy_info_file_names[i], FA_READ) == FR_OK &&
                f_read(&info_file, info, FLOPPY_INFO_TYPE_LENGTH, &read_bytes) == FR_OK) {
            if (strncmp(info, FLOPPY_INFO_TYPE_1440, FLOPPY_INFO_TYPE_LENGTH) == 0) {
                floppy_drives[i].drive_type_fun8h = FUN8H_DRIVE_TYPE_FLOPPY_1440;
                floppy_drives[i].drive_type_fun15h = FUN15H_DRIVE_TYPE_FLOPPY_DISK;

                floppy_drives[i].number_of_heads = FLOPPY_1440_NUMBER_OF_HEADS;
                floppy_drives[i].number_of_sectors = FLOPPY_1440_NUMBER_OF_SECTORS;
                floppy_drives[i].number_of_cylinders = FLOPPY_1440_NUMBER_OF_CYLINDERS;
            } else if (strncmp(info, FLOPPY_INFO_TYPE_720, FLOPPY_INFO_TYPE_LENGTH) == 0) {
                floppy_drives[i].drive_type_fun8h = FUN8H_DRIVE_TYPE_FLOPPY_720;
                floppy_drives[i].drive_type_fun15h = FUN15H_DRIVE_TYPE_FLOPPY_DISK;

                floppy_drives[i].number_of_heads = FLOPPY_720_NUMBER_OF_HEADS;
                floppy_drives[i].number_of_sectors = FLOPPY_720_NUMBER_OF_SECTORS;
                floppy_drives[i].number_of_cylinders = FLOPPY_720_NUMBER_OF_CYLINDERS;
            } else if (strncmp(info, FLOPPY_INFO_TYPE_1200, FLOPPY_INFO_TYPE_LENGTH) == 0) {
                floppy_drives[i].drive_type_fun8h = FUN8H_DRIVE_TYPE_FLOPPY_1200;
                floppy_drives[i].drive_type_fun15h = FUN15H_DRIVE_TYPE_FLOPPY_DISK;

                floppy_drives[i].number_of_heads = FLOPPY_1200_NUMBER_OF_HEADS;
                floppy_drives[i].number_of_sectors = FLOPPY_1200_NUMBER_OF_SECTORS;
                floppy_drives[i].number_of_cylinders = FLOPPY_1200_NUMBER_OF_CYLINDERS;
            } else if (strncmp(info, FLOPPY_INFO_TYPE_360, FLOPPY_INFO_TYPE_LENGTH) == 0) {
                floppy_drives[i].drive_type_fun8h = FUN8H_DRIVE_TYPE_FLOPPY_360;
                floppy_drives[i].drive_type_fun15h = FUN15H_DRIVE_TYPE_FLOPPY_DISK;

                floppy_drives[i].number_of_heads = FLOPPY_360_NUMBER_OF_HEADS;
                floppy_drives[i].number_of_sectors = FLOPPY_360_NUMBER_OF_SECTORS;
                floppy_drives[i].number_of_cylinders = FLOPPY_360_NUMBER_OF_CYLINDERS;
            } else if (strncmp(info, FLOPPY_INFO_TYPE_180, FLOPPY_INFO_TYPE_LENGTH) == 0) {
                floppy_drives[i].drive_type_fun8h = FUN8H_DRIVE_TYPE_FLOPPY_360;
                floppy_drives[i].drive_type_fun15h = FUN15H_DRIVE_TYPE_FLOPPY_DISK;

                floppy_drives[i].number_of_heads = FLOPPY_180_NUMBER_OF_HEADS;
                floppy_drives[i].number_of_sectors = FLOPPY_180_NUMBER_OF_SECTORS;
                floppy_drives[i].number_of_cylinders = FLOPPY_180_NUMBER_OF_CYLINDERS;
            } else if (strncmp(info, FLOPPY_INFO_TYPE_320, FLOPPY_INFO_TYPE_LENGTH) == 0) {
                floppy_drives[i].drive_type_fun8h = FUN8H_DRIVE_TYPE_FLOPPY_360;
                floppy_drives[i].drive_type_fun15h = FUN15H_DRIVE_TYPE_FLOPPY_DISK;

                floppy_drives[i].number_of_heads = FLOPPY_320_NUMBER_OF_HEADS;
                floppy_drives[i].number_of_sectors = FLOPPY_320_NUMBER_OF_SECTORS;
                floppy_drives[i].number_of_cylinders = FLOPPY_320_NUMBER_OF_CYLINDERS;
            } else if (strncmp(info, FLOPPY_INFO_TYPE_160, FLOPPY_INFO_TYPE_LENGTH) == 0) {
                floppy_drives[i].drive_type_fun8h = FUN8H_DRIVE_TYPE_FLOPPY_360;
                floppy_drives[i].drive_type_fun15h = FUN15H_DRIVE_TYPE_FLOPPY_DISK;

                floppy_drives[i].number_of_heads = FLOPPY_160_NUMBER_OF_HEADS;
                floppy_drives[i].number_of_sectors = FLOPPY_160_NUMBER_OF_SECTORS;
                floppy_drives[i].number_of_cylinders = FLOPPY_160_NUMBER_OF_CYLINDERS;
            }

#ifdef DEBUG
            if (has_geometry(&floppy_drives[i])) {
                printf("FOUND FLOPPY%d.TXT[c=%d,h=%d,s=%d]\r\n",
                        i,
                        floppy_drives[i].number_of_cylinders,
                        floppy_drives[i].number_of_heads,
                        floppy_drives[i].number_of_sectors
                        );
            }
#endif                                                    
        }
    }

    for (size_t i = 0; i < MAX_NUMBER_FLOPPY_DRIVES; i++) {
        if (has_geometry(&floppy_drives[i])) {
            if (f_stat(floppy_image_file_names[i], &file_info) == FR_OK &&
                    file_info.fsize == disk_size_bytes(&floppy_drives[i])) {
                if (
                        f_open(&floppy_drives[i].image_file, floppy_image_file_names[i], FA_READ | FA_WRITE) == FR_OK &&
                        setup_clmt(&floppy_drives[i].image_file, floppy_image_file_cltbl[i], FLOPPY_IMAGE_FILE_CLTBL_SIZE) == FR_OK &&
                        f_lseek(&floppy_drives[i].image_file, CREATE_LINKMAP) == FR_OK) {

                    if (f_stat(floppy_ro_file_names[i], &file_info) == FR_OK) {
                        floppy_drives[i].read_only = true;
                    }

                    floppy_drives[i].media_changed = true;

#ifdef DEBUG
                    if (has_image(&floppy_drives[i])) {
                        printf("MOUNTED FLOPPY%d.IMG[ro=%d,f=%ld]\r\n",
                                i,
                                floppy_drives[i].read_only,
                                floppy_image_file_cltbl[i][0]);
                    }
#endif                            
                } else {
#ifdef DEBUG
                    printf("TOO MANY FRAGMENTS FLOPPY%d.IMG[f=%ld]\r\n",
                            i,
                            floppy_image_file_cltbl[i][0]);
#endif                                

                    f_close(&floppy_drives[i].image_file);
                }
            } else {
#ifdef DEBUG
                printf("NOT FOUND OR BAD SIZE FLOPPY%d.IMG\r\n", i);
#endif                                                    
            }
        }
    }

    for (size_t i = 0; i < MAX_NUMBER_HARD_DRIVES; i++) {
        if (f_stat(hard_image_file_names[i], &file_info) == FR_OK) {
            FSIZE_t size = file_info.fsize;

            if (size > HARD_CYLINDER_SIZE_BYTES) {
                if (
                        f_open(&hard_drives[i].image_file, hard_image_file_names[i], FA_READ | FA_WRITE) == FR_OK &&
                        setup_clmt(&hard_drives[i].image_file, hard_image_file_cltbl[i], HARD_IMAGE_FILE_CLTBL_SIZE) == FR_OK &&
                        f_lseek(&hard_drives[i].image_file, CREATE_LINKMAP) == FR_OK) {
                    hard_drives[i].drive_type_fun8h = 0;
                    hard_drives[i].drive_type_fun15h = FUN15H_DRIVE_TYPE_HARD_DISK;

                    hard_drives[i].number_of_heads = HARD_NUMBER_OF_HEADS;
                    hard_drives[i].number_of_sectors = HARD_NUMBER_OF_SECTORS;
                    hard_drives[i].number_of_cylinders = size / HARD_CYLINDER_SIZE_BYTES;

                    if (hard_drives[i].number_of_cylinders > HARD_MAX_NUMBER_OF_CYLINDERS)
                        hard_drives[i].number_of_cylinders = HARD_MAX_NUMBER_OF_CYLINDERS;

#ifdef DEBUG
                    printf("MOUNTED HARD%d.IMG[c=%d,h=%d,s=%d,f=%ld]\r\n",
                            i,
                            hard_drives[i].number_of_cylinders,
                            hard_drives[i].number_of_heads,
                            hard_drives[i].number_of_sectors,
                            hard_image_file_cltbl[i][0]);
#endif                                
                } else {
#ifdef DEBUG
                    printf("TOO MANY FRAGMENTS HARD%d.IMG[f=%ld]\r\n",
                            i,
                            hard_image_file_cltbl[i][0]);
#endif                                
                    f_close(&hard_drives[i].image_file);
                }
            } else {
#ifdef DEBUG
                printf("BAD SIZE HARD%d.IMG\r\n", i);
#endif                                                    
            }

        } else {
#ifdef DEBUG
            printf("NOT FOUND HARD%d.IMG\r\n", i);
#endif                                                    
        }
    }

    return true;
}

static void clear_drives(void) {
    for (size_t i = 0; i < MAX_NUMBER_FLOPPY_DRIVES; i++) {
        if (has_image(&floppy_drives[i])) {
            f_close(&floppy_drives[i].image_file);
        }
    }

    for (size_t i = 0; i < MAX_NUMBER_HARD_DRIVES; i++) {
        if (has_image(&hard_drives[i])) {
            f_close(&hard_drives[i].image_file);
        }
    }

    f_mount(0, "0:", 0);

#ifdef DEBUG
    printf("UNMOUNTED\r\n");
#endif                
}

/*
                         Main application
 */
void main(void) {
    // Initialize the device
    SYSTEM_Initialize();
    //INT0_SetInterruptHandler(handle_read);
    //INT1_SetInterruptHandler(handle_write);

    memset(ctrl_buffer, 0, CTRL_BUFFER_SIZE);
    struct Ctrl *ctrl = (struct Ctrl *) ctrl_buffer;

    // If using interrupts in PIC18 High/Low Priority Mode you need to enable the Global High and Low Interrupts
    // If using interrupts in PIC Mid-Range Compatibility Mode you need to enable the Global and Peripheral Interrupts
    // Use the following macros to:

    // Enable the Global Interrupts
    INTERRUPT_GlobalInterruptEnable();

    // Disable the Global Interrupts
    //INTERRUPT_GlobalInterruptDisable();

    ACK_IO_Strobe();

    init_transfer(&read_mst, stop_read_sectors, start_read_sectors, read_next_sector);
    init_transfer(&write_mst, stop_write_sectors, start_write_sectors, write_next_sector);

    while (1) {
        if (SD_SPI_IsMediaPresent() && init_drives()) {
            while (SD_SPI_IsMediaPresent()) {
                wait_or_handle_ctrl_request(
                        ctrl,
                        wait_media_present,
                        handle_media_present
                        );
            }

            abort_transfer(&read_mst);
            abort_transfer(&write_mst);
            clear_drives();
        } else {
            wait_or_handle_ctrl_request(
                    ctrl,
                    wait_media_not_present,
                    handle_media_not_present
                    );
        }
    }
}
/**
 End of File
 */
