poisk-1/hdd_card/(commit log)

2022-11-14 Adjust schematic
    [hdd_card.kicad_sch]
2022-11-14 Activity LED
    [hdd_card.kicad_sch]
2022-11-15 UART pins
    [hdd_card.kicad_sch]
2022-11-15 Configure UART
2022-11-15 Run UART at 115200 bps
    [hdd_card.kicad_sch]
2022-12-03 Connect SDCARD_CD
    [hdd_card.kicad_sch]
2022-12-05 Connectors in schematic
    [hdd_card.kicad_sch]
2022-12-06 Fix SDCARD pinout
    [hdd_card.kicad_sch]
2022-12-06 Log mount/unmount
2022-12-06 4K IO aperture
    [hdd_card.kicad_sch]
2022-12-07 Configurable memory mapping to 128 byte blocks
    [hdd_card.kicad_sch]
2022-12-11 Check adapter before installing the int13h handler
    [hdd_card.kicad_sch]
2022-12-12 Support formatting floppies
    [hdd_card.kicad_sch]
2022-12-17 Support 1024 cylinders and verify CHS
2022-12-19 Fix for cross-track drive requests
    [main.c]
2022-12-20 Decode SEL_BIOS
    [hdd_card.kicad_sch]
2022-12-22 MBR mount/umount scripts
2022-12-23 Fix reset function handling
    [bios.asm, main.c]
2023-01-12 IRQ_DONE <-> INTR5
    [hdd_card.kicad_sch]
2023-01-18 Request complete interrupt. Multi-sector IO data.
    [hdd_card.kicad_sch]
2023-01-22 Round IO size to 8K
    [hdd_card.kicad_pcb]
